ap-tech/-Outboard-System-kit-for-ASVs/README.md

# -Outboard-System-kit-for-ASVs
This is a kit for turning the blue robotics T200 or T100 trusters into an outboard motor for ASVs in the 1 to 1.5 meter range.
