ap-tech/-Outboard-System-kit-for-ASVs/OutBoard Part/Servo_STL.stl

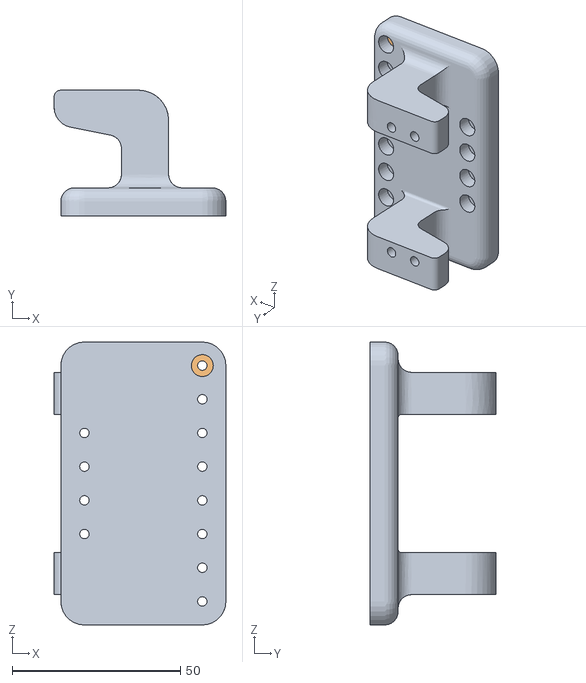
[picture p15: CAD file, 2026-02-20]
OutBoard Part/Servo_STL.stl
51.0 x 37.3 x 84.0
