ap-tech/-Outboard-System-kit-for-ASVs/Tooling/Tool_s1.stl

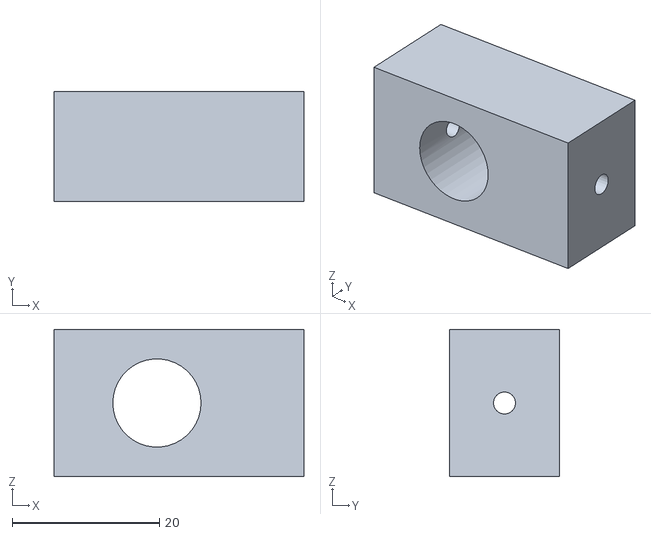
[picture p16: CAD file, 2026-02-20]
Tooling/Tool_s1.stl
34.0 x 15.0 x 20.0
