ap-tech/-Outboard-System-kit-for-ASVs/OutBoard Part/SERVO_ARM1.stl

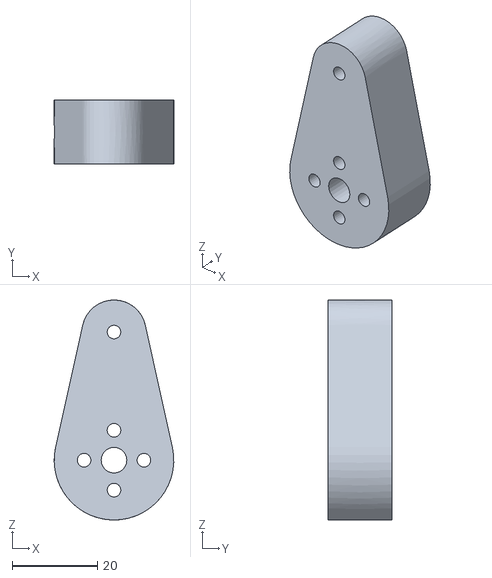
[picture p17: CAD file, 2026-02-20]
OutBoard Part/SERVO_ARM1.stl
28.0 x 15.0 x 51.5
