ap-tech/-Outboard-System-kit-for-ASVs/OutBoard Part/Stoper2.stl

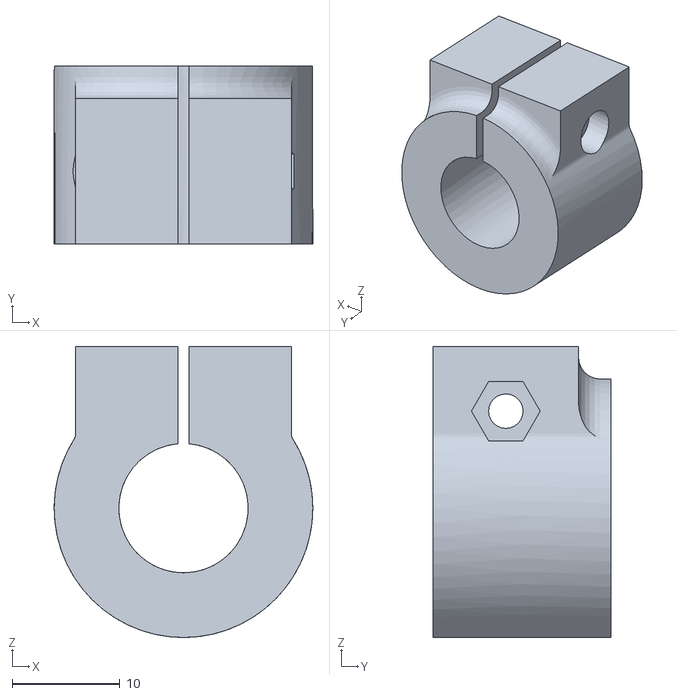
[picture p18: CAD file, 2026-02-20]
OutBoard Part/Stoper2.stl
24.0 x 16.5 x 27.0
