ap-tech/-Outboard-System-kit-for-ASVs/OutBoard Part/New1STL.stl

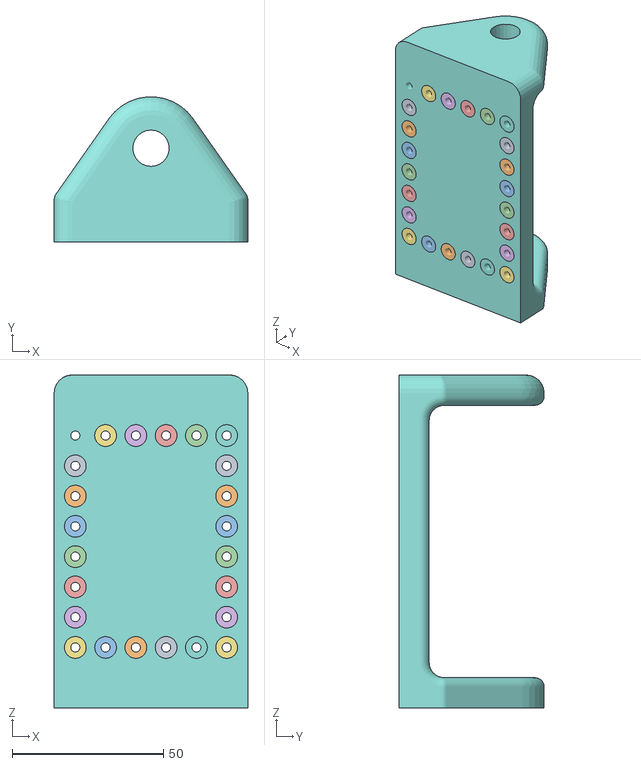
[picture p19: CAD file, 2026-02-20]
OutBoard Part/New1STL.stl
64.0 x 47.9 x 110.0
