ap-tech/-Outboard-System-kit-for-ASVs/OutBoard Part/B5.stl

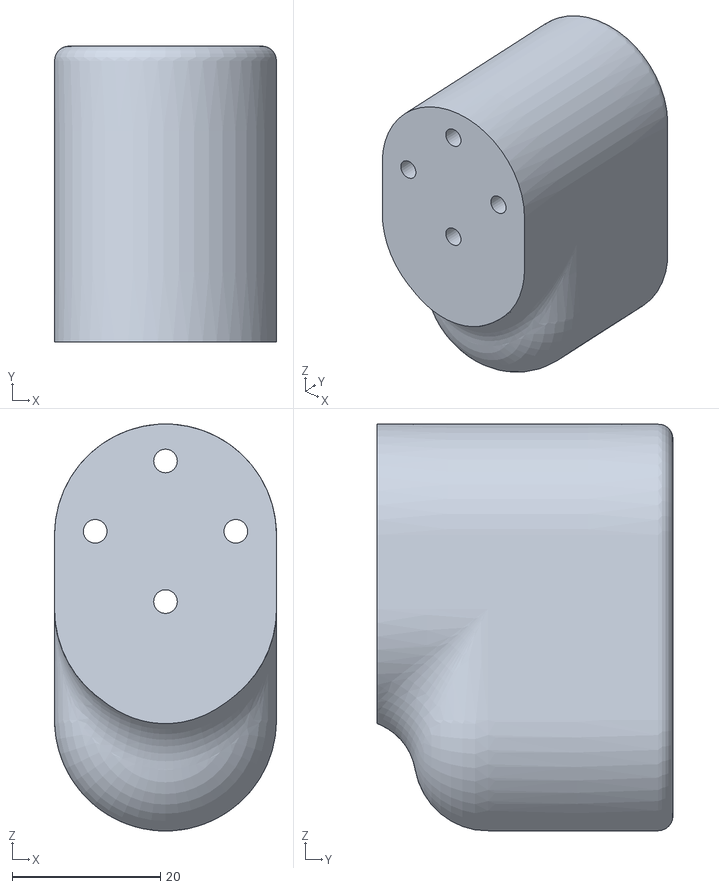
[picture p20: CAD file, 2026-02-20]
OutBoard Part/B5.stl
30.0 x 40.0 x 55.0
