ap-tech/-Outboard-System-kit-for-ASVs/OutBoard Part/gusset.stl

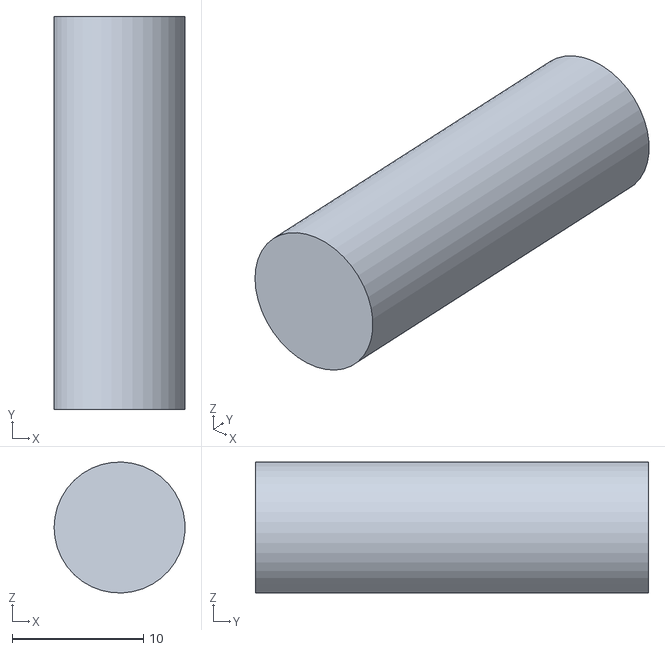
[picture p21: CAD file, 2026-02-20]
OutBoard Part/gusset.stl
9.98 x 30.0 x 9.99
