ap-tech/-Outboard-System-kit-for-ASVs/OutBoard Part/Untitled.stl

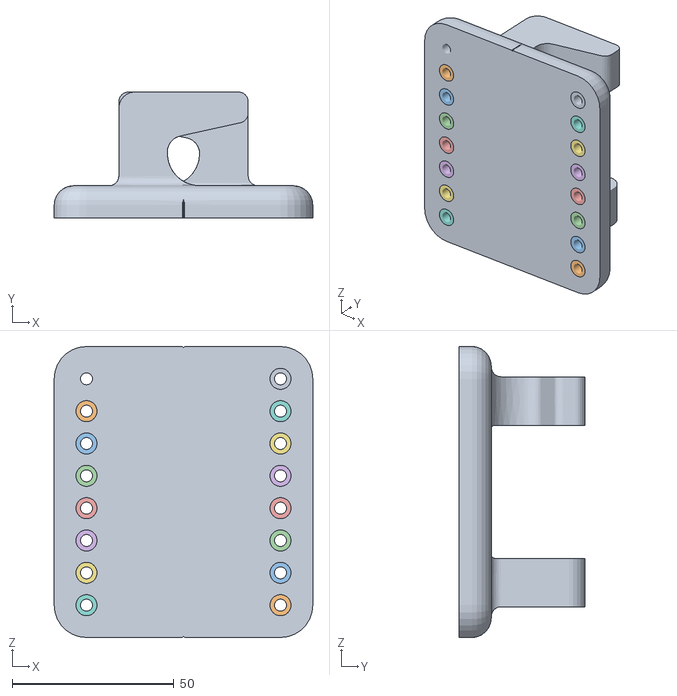
[picture p22: CAD file, 2026-02-20]
OutBoard Part/Untitled.stl
80.0 x 39.0 x 90.0
