ap-tech/-Outboard-System-kit-for-ASVs/OutBoard Part/AA5.stl

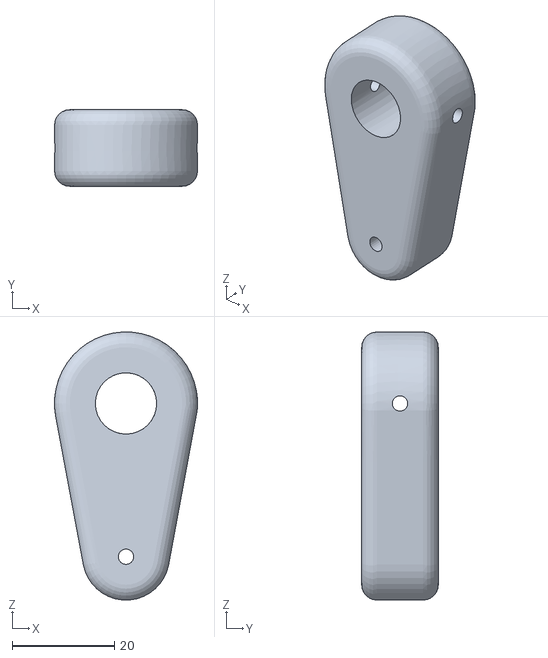
[picture p23: CAD file, 2026-02-20]
OutBoard Part/AA5.stl
28.0 x 15.0 x 52.5
